OpenBCI/Ganglion_Hardware_Design_Files/README.md

# Ganglion_Hardware_Design_Files
General repo for Ganglion hardware files 

All design files made with KiCad PCB design software.
http://kicad-pcb.org/

Disclaimer:

These files are presented AS IS, with no representation of warranty or functionality.
Designs are subject to change without notice.
