OpenBCI/Ganglion_Hardware_Design_Files/(threads)

Thread 3 (2018-03-22):

Feature Request: Powering the future of neurotech with a 3.3V pin

aj-ptw, 2018-03-22:
Currently the ganglion does not work if you power the Ganglion from the broken out 3.3V

Thread 4 (2018-08-01):

Libraries not found

rehno-lindeque, 2018-08-01:
Hi, upon opening the schematic in kicad I get some missing library links from @biomurph's personal library.

> The following libraries were not found:
>
> /Users/biomurph/Documents/KiCad/library/OpenBCI

biomurph, 2018-08-01:
You need to create a new path for the libraries.
In KiCAD, go to Preferences > Configure Paths
Then point to the OpenBCI_KiCad_librariy_files folder.

Closed 2018-08-01.
