OpenBCI/Ganglion_Hardware_Design_Files/Ganglion_KiCad_Files/Ganglion_01.kicad_pcb

## KiCad design Ganglion_KiCad_Files/Ganglion_01.kicad_pcb (2017-01-11)

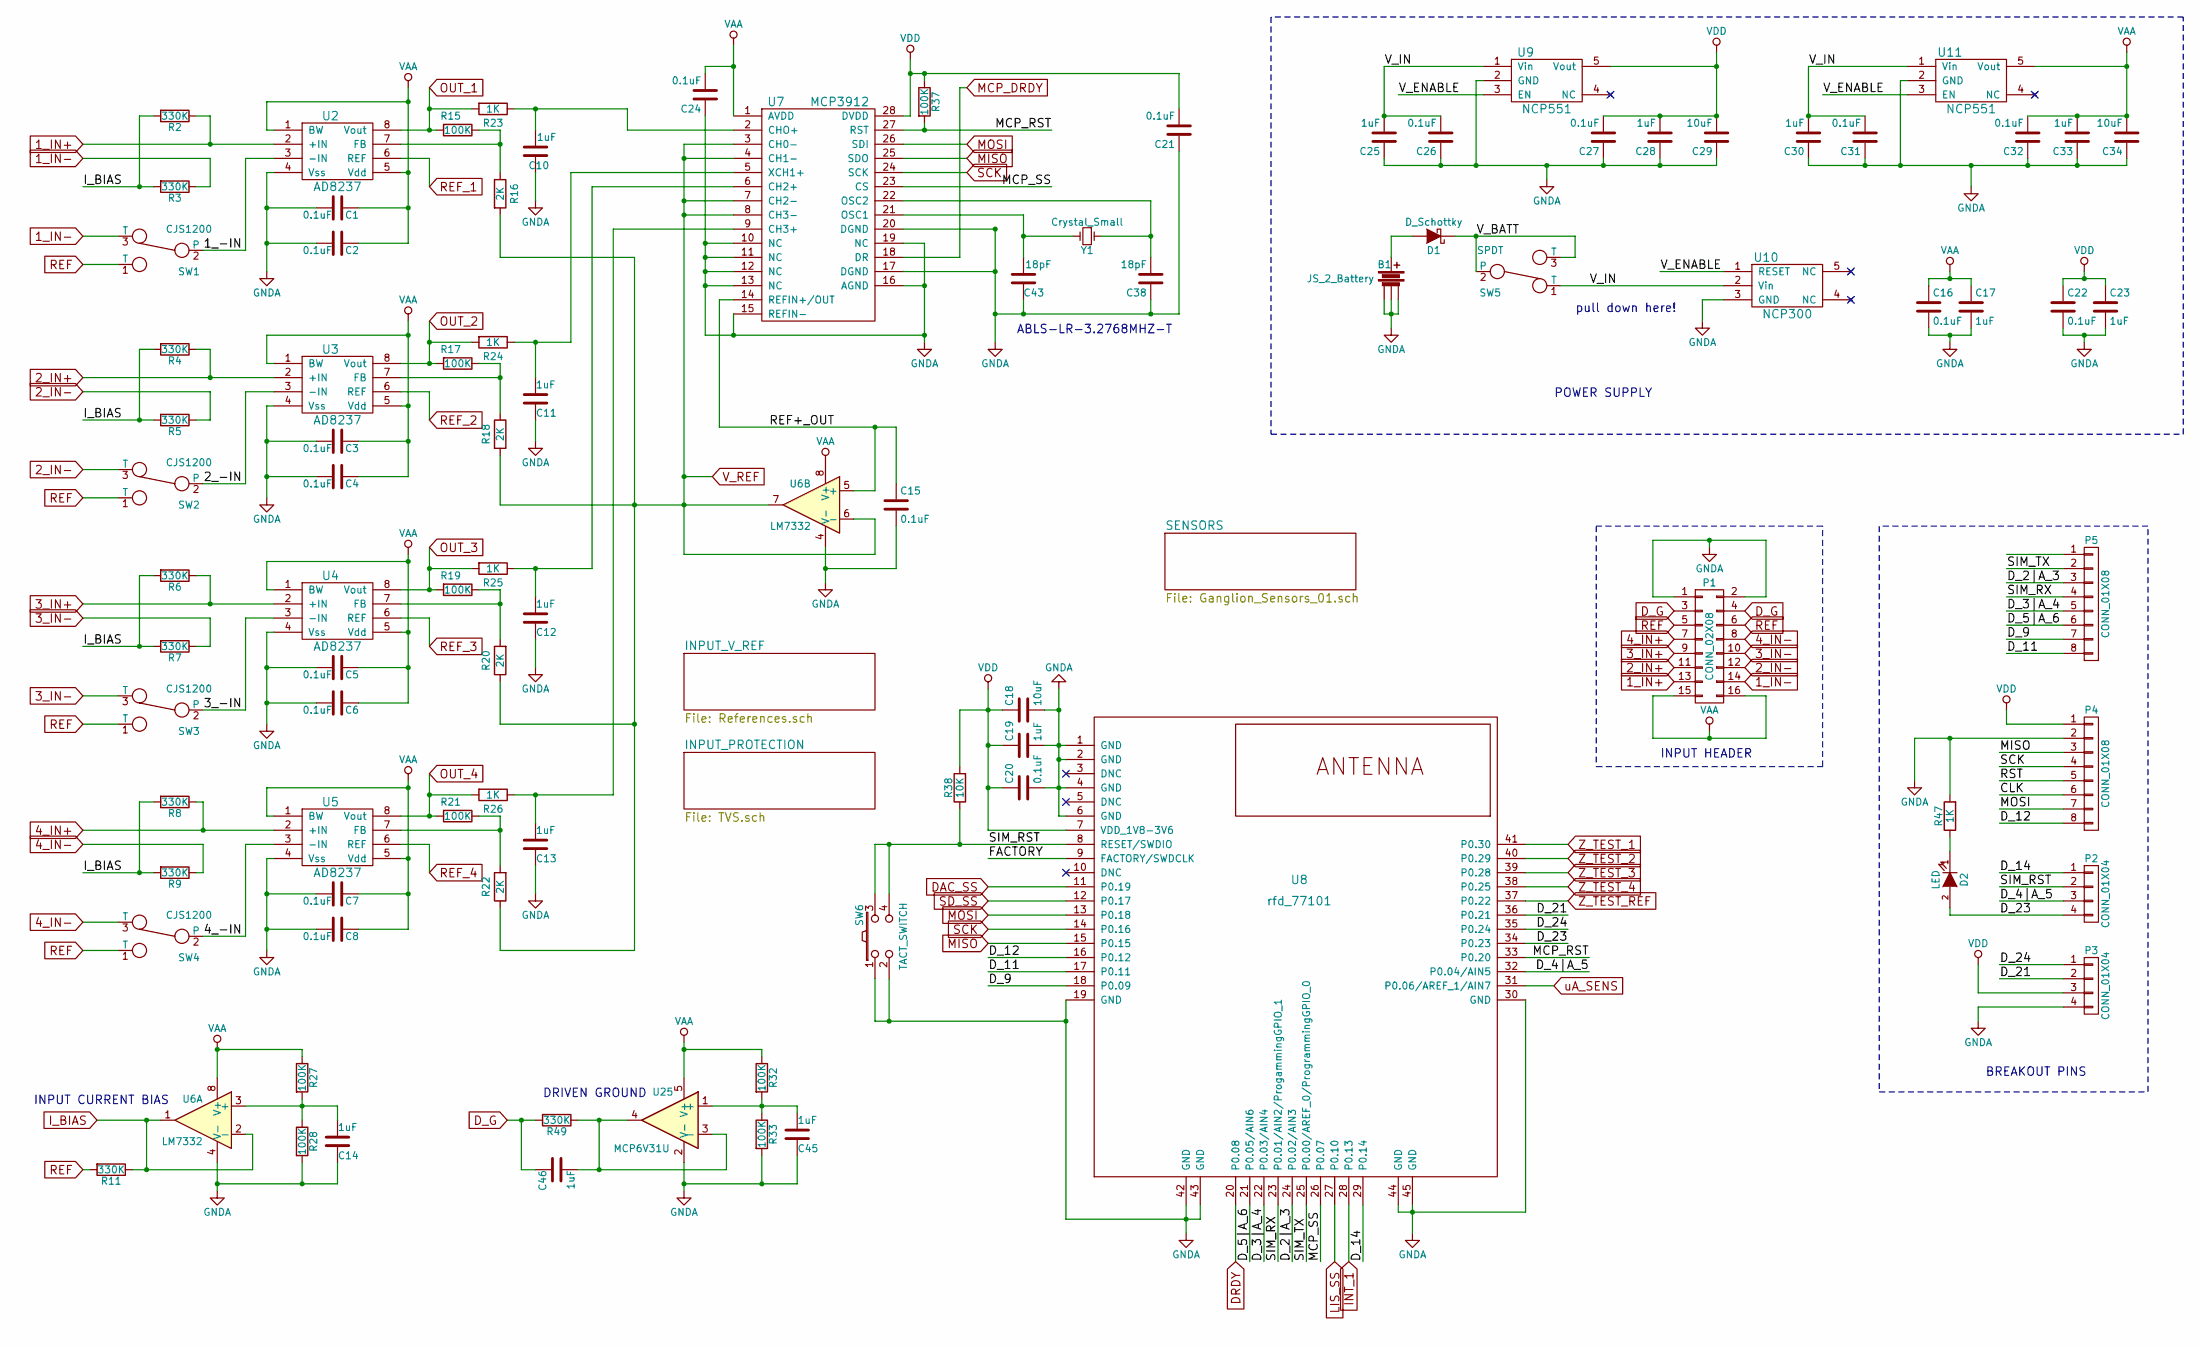
[picture p5: schematic Ganglion_01.sch, Ganglion]

Parts:
B1: JS_2_Battery; JST_RA_SMT
C1, C2, C3, C4, C5, C6, C7, C8, C15, C16, C20, C21, C22, C24, C26, C27, C31, C32: 0.1uF; C_0603
C10, C11, C12, C13, C14, C17, C19, C23, C25, C28, C30, C33, C45, C46: 1uF; C_0603
C18, C29, C34: 10uF; C_0603
C38, C43: 18pF; C_0603
D1: D_Schottky; C_0603
D2: LED; LED_0603
P1: CONN_02X08; Pin_Header_Angled_2x08
P2, P3: CONN_01X04; Socket_Strip_Straight_1x04
P4, P5: CONN_01X08; Socket_Strip_Straight_1x08
R2, R3, R4, R5, R6, R7, R8, R9, R11, R49: 330K; R_0603
R15, R17, R19, R21, R27, R28, R32, R33, R37: 100K; R_0603
R16, R18, R20, R22: 2K; R_0603
R23, R24, R25, R26, R47: 1K; R_0603
R38: 10K; R_0603
SW1, SW2, SW3, SW4: CJS1200; CJS-1200TA
SW5: SPDT; SSSS810701 SSSS810701
SW6: TACT_SWITCH; PTS810
U2, U3, U4, U5: AD8237; MSOP-8_3x3mm_Pitch0.65mm
U6: LM7332; MSOP-8_3x3mm_Pitch0.65mm
U7: MCP3912; SSOP-28_5.3x10.2mm_Pitch0.65mm
U8: rfd_77101; RFD77101
U9, U11: NCP551; SOT-23-5
U10: NCP300; SOT-23-5
U25: MCP6V31U; SC-70-5
Y1: Crystal_Small; Crystal_HC49-SD_SMD

Connections:
1_IN+: P1.13, R2.1, U2.2 (+IN); also elsewhere on the board
1_IN-: P1.14, R3.1, SW1.3 (T); also elsewhere on the board
2_IN+: P1.11, R4.1, U3.2 (+IN); also elsewhere on the board
2_IN-: P1.12, R5.1, SW2.3 (T); also elsewhere on the board
3_IN+: P1.9, R6.1, U4.2 (+IN); also elsewhere on the board
3_IN-: P1.10, R7.1, SW3.3 (T); also elsewhere on the board
4_IN+: P1.7, R8.1, U5.2 (+IN); also elsewhere on the board
4_IN-: P1.8, R9.1, SW4.3 (T); also elsewhere on the board
/1_-IN: SW1.2, U2.3 (-IN)
/2_-IN: SW2.2, U3.3 (-IN)
/3_-IN: SW3.2, U4.3 (-IN)
/4_-IN: SW4.2, U5.3 (-IN)
/CLK: P4.6
/D_2|A_3: P5.3, U8.24 (P0.02/AIN3)
/D_3|A_4: P5.5, U8.22 (P0.03/AIN4)
/D_4|A_5: P2.3, U8.32 (P0.04/AIN5)
/D_5|A_6: P5.6, U8.21 (P0.05/AIN6)
/D_9: P5.7, U8.18 (P0.09)
/D_11: P5.8, U8.17 (P0.11)
/D_12: P4.8, U8.16 (P0.12)
/D_14: P2.1, U8.29 (P0.14)
/D_21: P3.2, U8.36 (P0.21)
/D_23: D2.2 (A), P2.4, U8.34 (P0.23)
/D_24: P3.1, U8.35 (P0.24)
/FACTORY: U8.9 (FACTORY/SWDCLK)
/MCP_RST: R37.2, U7.27 (RST), U8.33 (P0.20)
/MCP_SS: U7.23 (CS), U8.26 (P0.07)
/REF+_OUT: C15.1, U6.5 (+), U7.14 (REFIN+/OUT)
/RST: P4.5
/SIM_RST: P2.2, R38.1, SW6.3, SW6.4, U8.8 (RESET/SWDIO)
/SIM_RX: P5.4, U8.23 (P0.01/AIN2/ProgammingGPIO_1)
/SIM_TX: P5.2, U8.25 (P0.00/AREF_0/ProgrammingGPIO_0)
/V_BATT: D1.1 (K), SW5.2, SW5.3 (T)
/V_ENABLE: U9.3 (EN), U10.1 (RESET), U11.3 (EN)
/V_IN: C25.2, C26.2, C30.2, C31.2, SW5.1 (T), U9.1 (Vin), U10.2 (Vin), U11.1 (Vin)
DAC_SS: U8.11 (P0.19); also elsewhere on the board
DRDY: U8.20 (P0.08); also elsewhere on the board
D_G: C46.2, P1.3, P1.4, R49.2; also elsewhere on the board
GNDA: B1.2, B1.3, B1.4, C1.2, C2.2, C3.2, C4.2, C5.2, C6.2, C7.2, C8.2, C10.1, C11.2, C12.2, C13.2, C14.2, C15.2, C16.2, C17.2, C18.2, C19.2, C20.2, C21.1, C22.2, C23.2, C24.1, C25.1, C26.1, C27.1, C28.1, C29.1, C30.1, C31.1, C32.1, C33.1, C34.1, C38.1, C43.1, C45.2, P1.1, P1.2, P3.4, P4.2, R28.2, R33.2, R47.2, SW6.1, SW6.2, U2.4 (Vss), U3.4 (Vss), U4.4 (Vss), U5.4 (Vss), U6.4 (V-), U7.10 (NC), U7.11 (NC), U7.12 (NC), U7.13 (NC), U7.15 (REFIN-), U7.16 (AGND), U7.17 (DGND), U7.19 (NC), U7.20 (DGND), U8.1 (GND), U8.2 (GND), U8.4 (GND), U8.6 (GND), U8.19 (GND), U8.30 (GND), U8.42 (GND), U8.43 (GND), U8.44 (GND), U8.45 (GND), U9.2 (GND), U10.3 (GND), U11.2 (GND), U25.2 (V-); also elsewhere on the board
INT_1: U8.28 (P0.13); also elsewhere on the board
I_BIAS: R2.2, R3.2, R4.2, R5.2, R6.2, R7.2, R8.2, R9.2, R11.1, U6.1, U6.2 (-)
LIS_SS: U8.27 (P0.10); also elsewhere on the board
MCP_DRDY: U7.18 (DR); also elsewhere on the board
MISO: P4.3, U7.25 (SDO), U8.15 (P0.15); also elsewhere on the board
MOSI: P4.7, U7.26 (SDI), U8.13 (P0.18); also elsewhere on the board
unnamed: B1.1, D1.2 (A)
unnamed: C10.2, R23.1, U7.2 (CHO+)
unnamed: C11.1, R24.1, U7.5 (XCH1+)
unnamed: C12.1, R25.1, U7.6 (CH2+)
unnamed: C13.1, R26.1, U7.9 (CH3+)
unnamed: C14.1, R27.2, R28.1, U6.3 (+)
unnamed: C38.2, U7.22 (OSC2), Y1.1
unnamed: C43.2, U7.21 (OSC1), Y1.2
unnamed: C45.1, R32.2, R33.1, U25.1 (+)
unnamed: C46.1, R49.1, U25.3 (-), U25.4
unnamed: D2.1 (K), R47.1
unnamed: R15.1, R16.1, U2.7 (FB)
unnamed: R17.1, R18.1, U3.7 (FB)
unnamed: R19.1, R20.2, U4.7 (FB)
unnamed: R21.1, R22.2, U5.7 (FB)
OUT_1: R15.2, R23.2, U2.8 (Vout); also elsewhere on the board
OUT_2: R17.2, R24.2, U3.8 (Vout); also elsewhere on the board
OUT_3: R19.2, R25.2, U4.8 (Vout); also elsewhere on the board
OUT_4: R21.2, R26.2, U5.8 (Vout); also elsewhere on the board
REF: P1.5, P1.6, R11.2, SW1.1 (T), SW2.1 (T), SW3.1 (T), SW4.1 (T); also elsewhere on the board
REF_1: U2.6 (REF); also elsewhere on the board
REF_2: U3.6 (REF); also elsewhere on the board
REF_3: U4.6 (REF); also elsewhere on the board
REF_4: U5.6 (REF); also elsewhere on the board
SCK: P4.4, U7.24 (SCK), U8.14 (P0.16); also elsewhere on the board
SD_SS: U8.12 (P0.17); also elsewhere on the board
VAA: C1.1, C2.1, C3.1, C4.1, C5.1, C6.1, C7.1, C8.1, C16.1, C17.1, C24.2, C32.2, C33.2, C34.2, P1.15, P1.16, R27.1, R32.1, U2.1 (BW), U2.5 (Vdd), U3.1 (BW), U3.5 (Vdd), U4.1 (BW), U4.5 (Vdd), U5.1 (BW), U5.5 (Vdd), U6.8 (V+), U7.1 (AVDD), U11.5 (Vout), U25.5 (V+); also elsewhere on the board
VDD: C18.1, C19.1, C20.1, C21.2, C22.1, C23.1, C27.2, C28.2, C29.2, P3.3, P4.1, R37.1, R38.2, U7.28 (DVDD), U8.7 (VDD_1V8-3V6), U9.5 (Vout); also elsewhere on the board
V_REF: R16.2, R18.2, R20.1, R22.1, U6.6 (-), U6.7, U7.3 (CH0-), U7.4 (CH1-), U7.7 (CH2-), U7.8 (CH3-); also elsewhere on the board
Z_TEST_1: U8.41 (P0.30); also elsewhere on the board
Z_TEST_2: U8.40 (P0.29); also elsewhere on the board
Z_TEST_3: U8.39 (P0.28); also elsewhere on the board
Z_TEST_4: U8.38 (P0.25); also elsewhere on the board
Z_TEST_REF: U8.37 (P0.22); also elsewhere on the board
uA_SENS: U8.31 (P0.06/AREF_1/AIN7); also elsewhere on the board

Notes on the sheet:
POWER SUPPLY
BREAKOUT PINS
pull down here!
ABLS-LR-3.2768MHZ-T
DRIVEN GROUND
INPUT CURRENT BIAS
INPUT HEADER

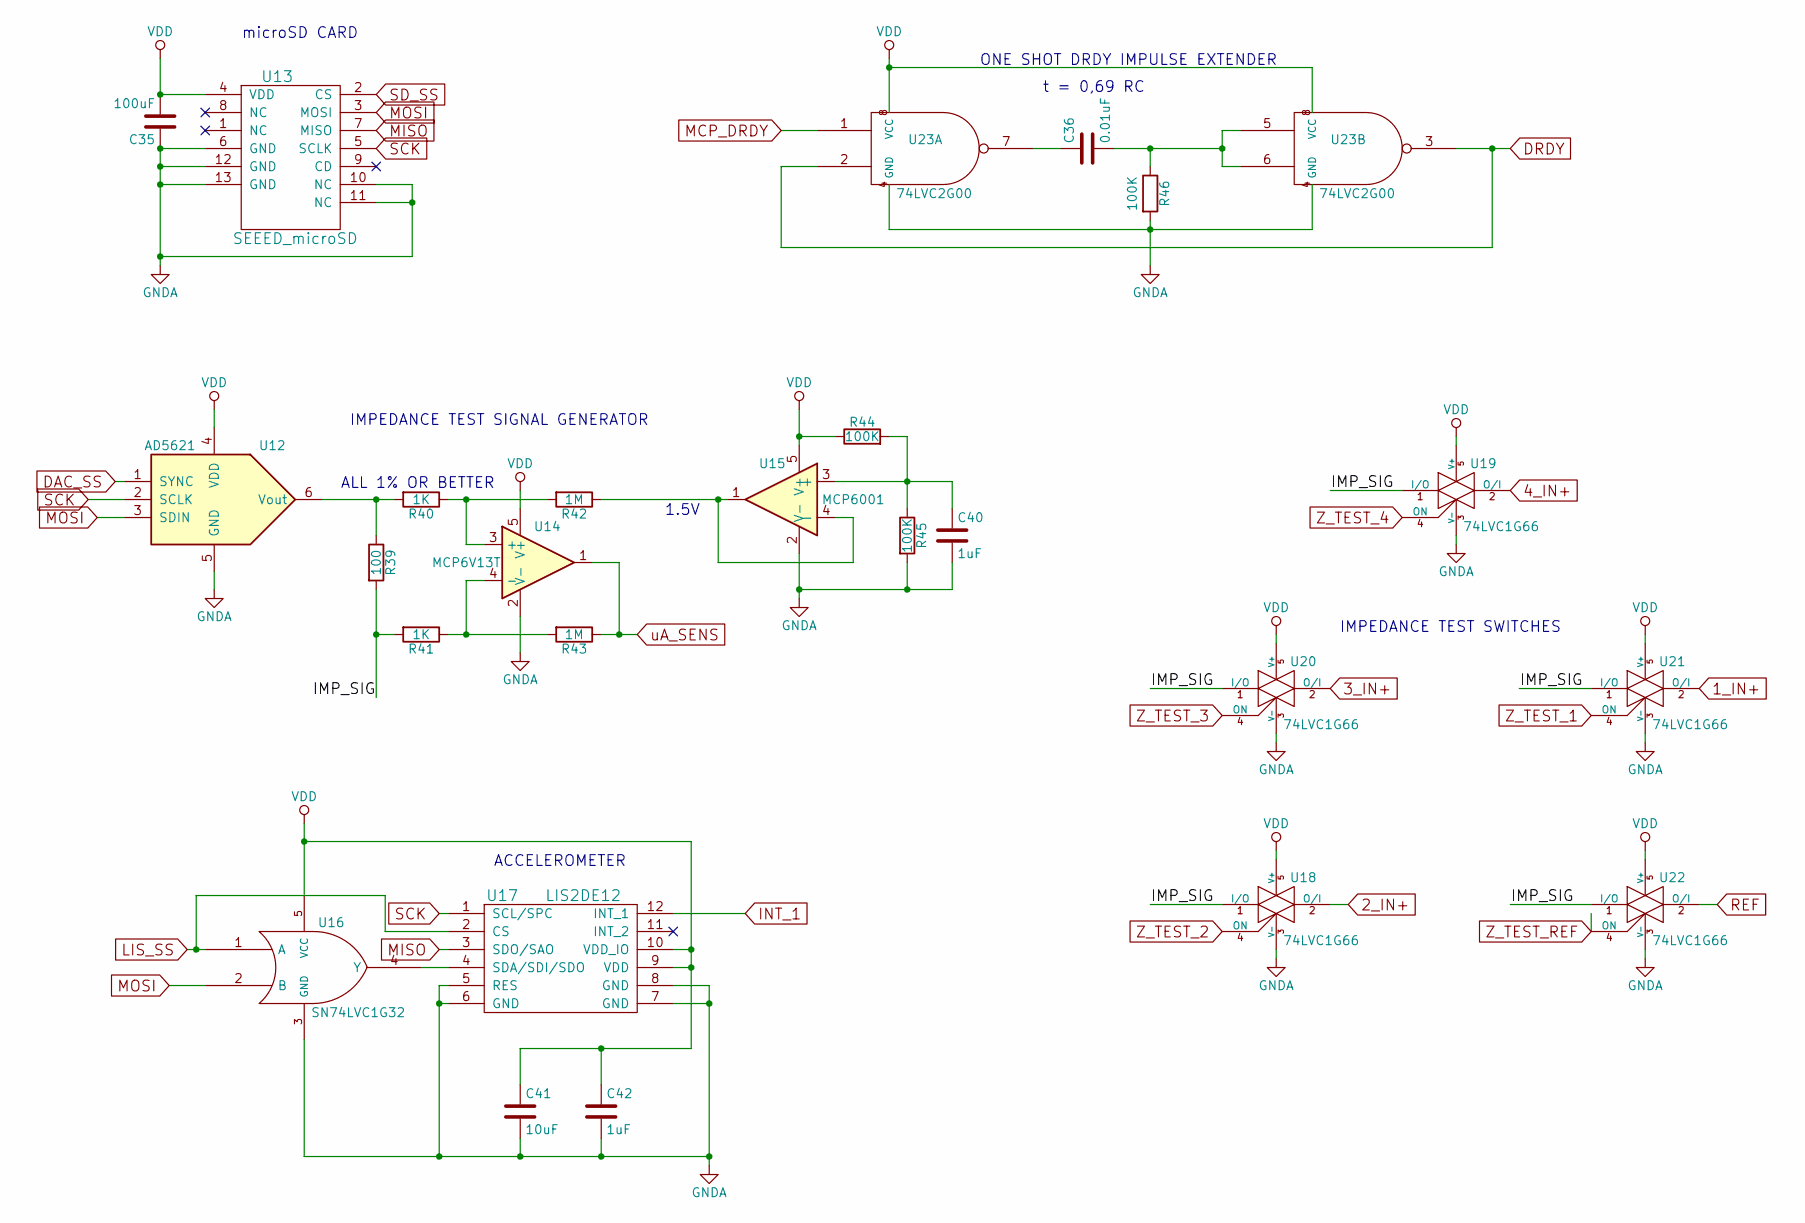
[picture p6: schematic Ganglion_Sensors_01.sch, Ganglion Peripherals]

Parts:
C35: 100uF; C_1210
C36: 0.01uF; C_0603
C40, C42: 1uF; C_0603
C41: 10uF; C_0603
R39: 100; R_0603
R40, R41: 1K; R_0603
R42, R43: 1M; R_0603
R44, R45, R46: 100K; R_0603
U12: AD5621; SC-70-6
U13: SEEED_microSD; ST-TF-0003A
U14: MCP6V13T; SOT-23-5
U15: MCP6001; SC-70-5
U16: SN74LVC1G32; SC-70-5
U17: LIS2DE12; LIS2DH12
U18, U19, U20, U21, U22: 74LVC1G66; SC-70-5
U23: 74LVC2G00; VSSOP-8

Connections:
1_IN+: U21.2 (O/I); also elsewhere on the board
2_IN+: U18.2 (O/I); also elsewhere on the board
3_IN+: U20.2 (O/I); also elsewhere on the board
4_IN+: U19.2 (O/I); also elsewhere on the board
/SENSORS/IMP_SIG: R39.2, R41.2, U18.1 (I/O), U19.1 (I/O), U20.1 (I/O), U21.1 (I/O), U22.1 (I/O)
DAC_SS: U12.1 (SYNC); also elsewhere on the board
DRDY: U23.2, U23.3; also elsewhere on the board
GNDA: C35.1, C40.2, C41.2, C42.2, R45.2, R46.2, U12.5 (GND), U13.6 (GND), U13.10 (NC), U13.11 (NC), U13.12 (GND), U13.13 (GND), U14.2 (V-), U15.2 (V-), U16.3 (GND), U17.5 (RES), U17.6 (GND), U17.7 (GND), U17.8 (GND), U18.3 (V-), U19.3 (V-), U20.3 (V-), U21.3 (V-), U22.3 (V-), U23.4 (GND); also elsewhere on the board
INT_1: U17.12 (INT_1); also elsewhere on the board
LIS_SS: U16.1 (A), U17.2 (CS); also elsewhere on the board
MCP_DRDY: U23.1; also elsewhere on the board
MISO: U13.7 (MISO), U17.3 (SDO/SAO); also elsewhere on the board
MOSI: U12.3 (SDIN), U13.3 (MOSI), U16.2 (B); also elsewhere on the board
unnamed: C36.1, U23.7
unnamed: C36.2, R46.1, U23.5, U23.6
unnamed: C40.1, R44.2, R45.1, U15.3 (+)
unnamed: R39.1, R40.2, U12.6 (Vout)
unnamed: R40.1, R42.2, U14.3 (+)
unnamed: R41.1, R43.2, U14.4 (-)
unnamed: R42.1, U15.1, U15.4 (-)
unnamed: U16.4 (Y), U17.4 (SDA/SDI/SDO)
REF: U22.2 (O/I); also elsewhere on the board
SCK: U12.2 (SCLK), U13.5 (SCLK), U17.1 (SCL/SPC); also elsewhere on the board
SD_SS: U13.2 (CS); also elsewhere on the board
VDD: C35.2, C41.1, C42.1, R44.1, U12.4 (VDD), U13.4 (VDD), U14.5 (V+), U15.5 (V+), U16.5 (VCC), U17.9 (VDD), U17.10 (VDD_IO), U18.5 (V+), U19.5 (V+), U20.5 (V+), U21.5 (V+), U22.5 (V+), U23.8 (VCC); also elsewhere on the board
Z_TEST_1: U21.4 (ON); also elsewhere on the board
Z_TEST_2: U18.4 (ON); also elsewhere on the board
Z_TEST_3: U20.4 (ON); also elsewhere on the board
Z_TEST_4: U19.4 (ON); also elsewhere on the board
Z_TEST_REF: U22.4 (ON); also elsewhere on the board
uA_SENS: R43.1, U14.1; also elsewhere on the board

Notes on the sheet:
1.5V
ALL 1% OR BETTER
ACCELEROMETER
microSD CARD
IMPEDANCE TEST SIGNAL GENERATOR
ONE SHOT DRDY IMPULSE EXTENDER
t = 0,69 RC
IMPEDANCE TEST SWITCHES

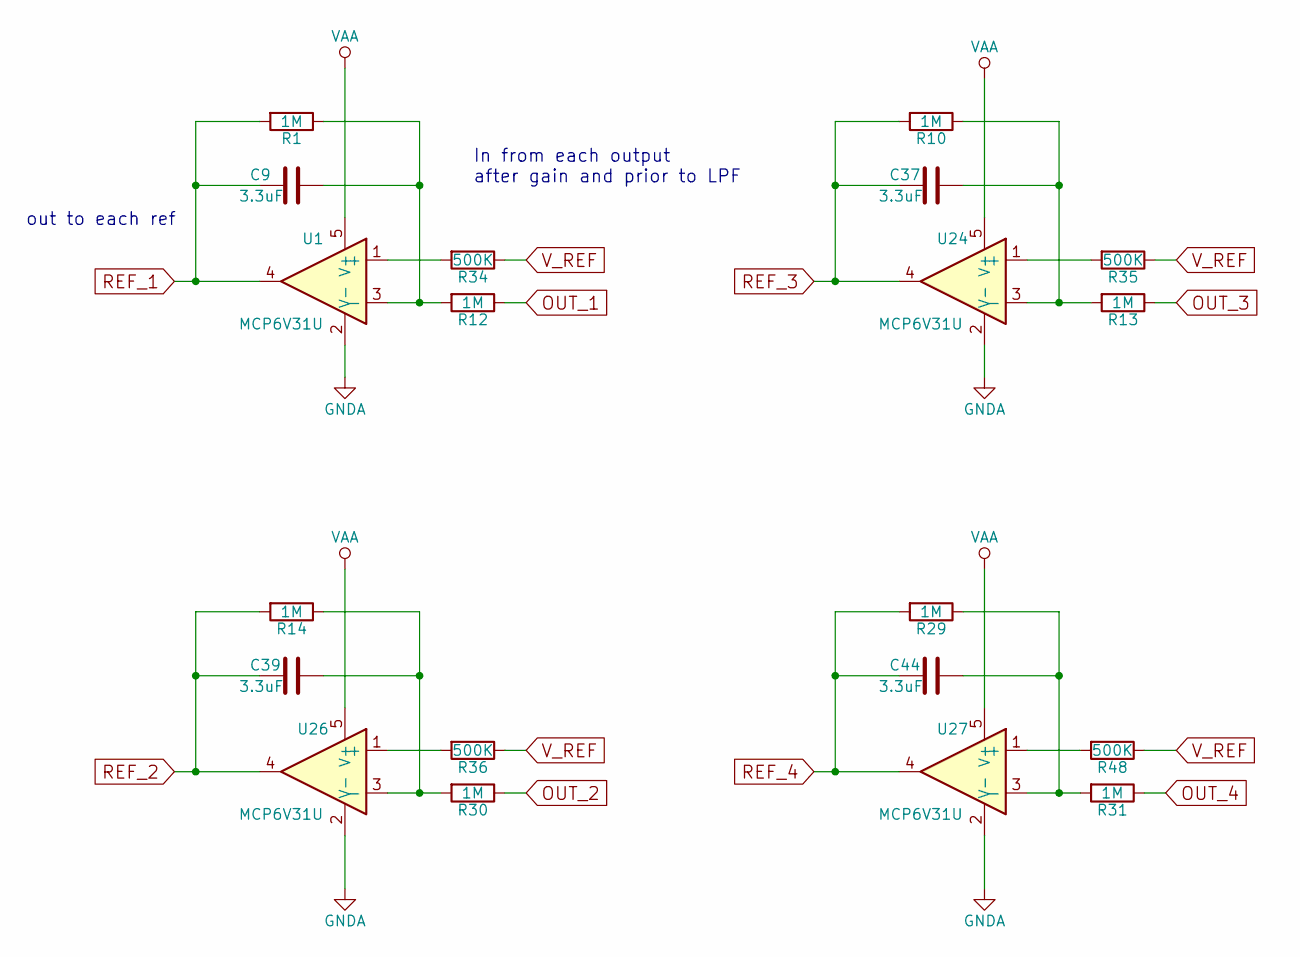
[picture p7: schematic References.sch, Ganglion Input Voltage References]

Parts:
C9, C37, C39, C44: 3.3uF; C_0603
R1, R10, R12, R13, R14, R29, R30, R31: 1M; C_0603
R34, R35, R36, R48: 500K; C_0603
U1, U24, U26, U27: MCP6V31U; SC-70-5

Connections:
GNDA: U1.2 (V-), U24.2 (V-), U26.2 (V-), U27.2 (V-); also elsewhere on the board
unnamed: C9.1, R1.1, R12.2, U1.3 (-)
unnamed: C37.1, R10.1, R13.2, U24.3 (-)
unnamed: C39.1, R14.1, R30.2, U26.3 (-)
unnamed: C44.1, R29.1, R31.2, U27.3 (-)
unnamed: R34.2, U1.1 (+)
unnamed: R35.2, U24.1 (+)
unnamed: R36.2, U26.1 (+)
unnamed: R48.2, U27.1 (+)
OUT_1: R12.1; also elsewhere on the board
OUT_2: R30.1; also elsewhere on the board
OUT_3: R13.1; also elsewhere on the board
OUT_4: R31.1; also elsewhere on the board
REF_1: C9.2, R1.2, U1.4; also elsewhere on the board
REF_2: C39.2, R14.2, U26.4; also elsewhere on the board
REF_3: C37.2, R10.2, U24.4; also elsewhere on the board
REF_4: C44.2, R29.2, U27.4; also elsewhere on the board
VAA: U1.5 (V+), U24.5 (V+), U26.5 (V+), U27.5 (V+); also elsewhere on the board
V_REF: R34.1, R35.1, R36.1, R48.1; also elsewhere on the board

Notes on the sheet:
In from each output after gain and prior to LPF
out to each ref

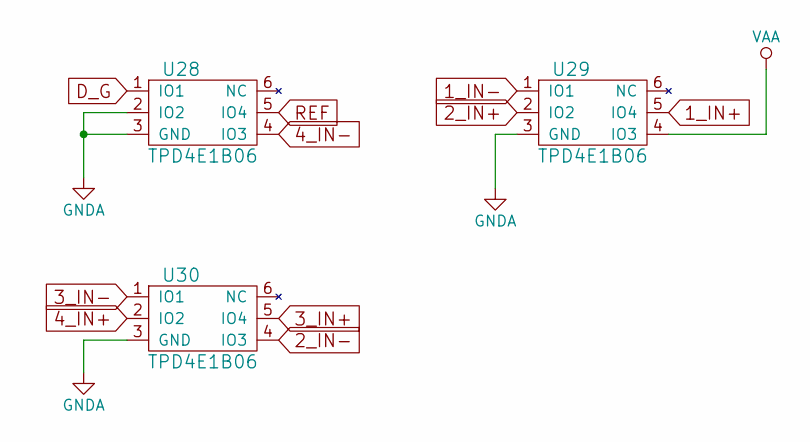
[picture p8: schematic TVS.sch, Ganglion Input Protection]

Parts:
U28, U29, U30: TPD4E1B06; SC-70-6

Connections:
1_IN+: U29.5 (IO4); also elsewhere on the board
1_IN-: U29.1 (IO1); also elsewhere on the board
2_IN+: U29.2 (IO2); also elsewhere on the board
2_IN-: U30.4 (IO3); also elsewhere on the board
3_IN+: U30.5 (IO4); also elsewhere on the board
3_IN-: U30.1 (IO1); also elsewhere on the board
4_IN+: U30.2 (IO2); also elsewhere on the board
4_IN-: U28.4 (IO3); also elsewhere on the board
D_G: U28.1 (IO1); also elsewhere on the board
GNDA: U28.2 (IO2), U28.3 (GND), U29.3 (GND), U30.3 (GND); also elsewhere on the board
REF: U28.5 (IO4); also elsewhere on the board
VAA: U29.4 (IO3); also elsewhere on the board

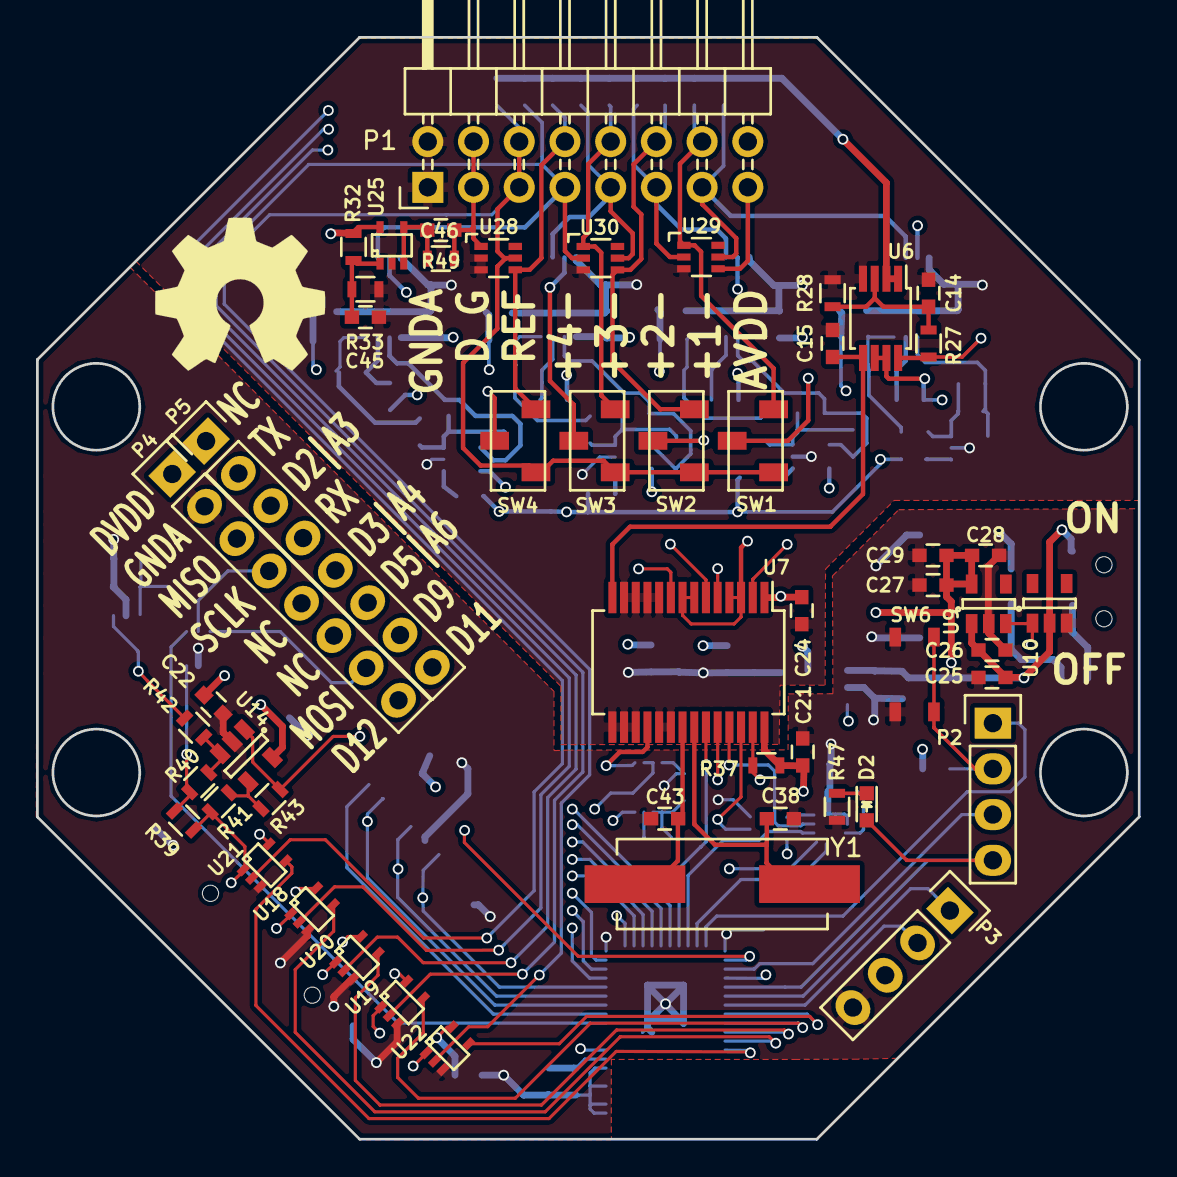
[picture p9: board Ganglion_01.kicad_pcb from above]

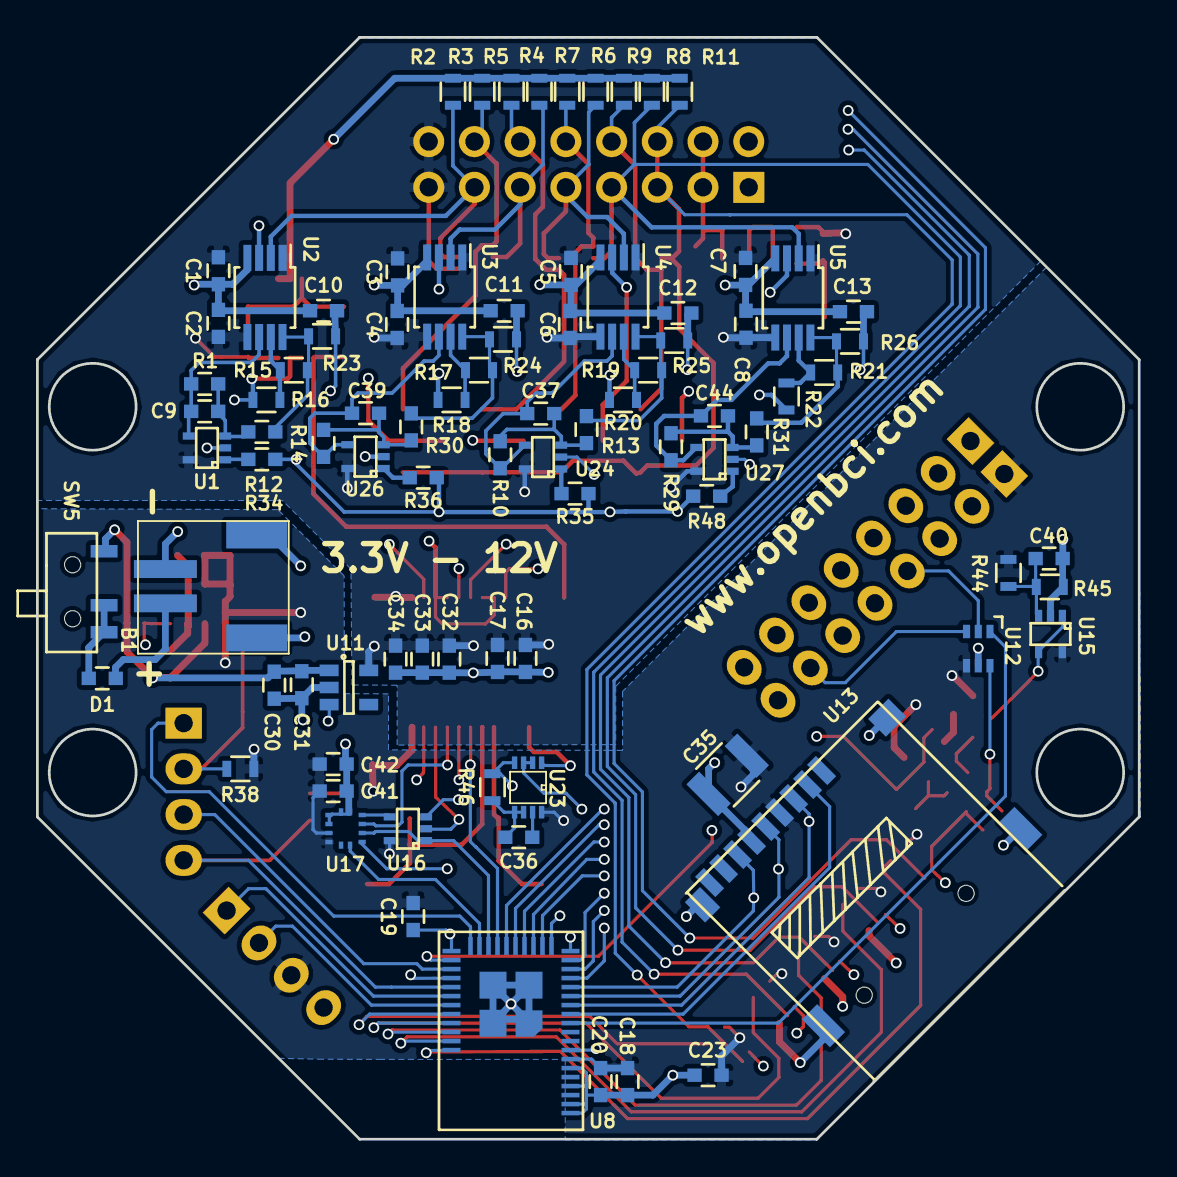
[picture p10: board Ganglion_01.kicad_pcb from below]

Board: 4 copper layers, 61.2 x 61.2 mm, 140 parts (88 on the bottom side), 94 nets.
