OpenBCI/Ganglion_Hardware_Design_Files/(commit log)

2016-10-18 Initial Commit
    Dropping KiCad Schematic and library files
    [Ganglion_01.sch, Ganglion_Sensors_01.sch, References.sch]
2016-10-18 added PDF of Schematic
    [Ganglion_01.sch, References.sch]
2016-10-19 small changes
    improved readability of shcematic
    [Ganglion_01.sch]
2016-10-24 small changes
    [Ganglion_01.sch, Ganglion_Sensors_01.sch, References.sch]
2017-01-11 Commit PCB files
    Update with the production schematic and PCB files. Also the BOM.
    You’re welcome.
    [Ganglion_01.kicad_pcb, Ganglion_01.sch, Ganglion_01_BOM.xlsx, Ganglion_Sensors_01.sch, References.sch, TVS.sch]
2017-09-18 Update License and add berbers
    [Ganglion_01-B.Cu.gbr, Ganglion_01-B.Mask.gbr, Ganglion_01-B.Paste.gbr, Ganglion_01-Edge.Cuts.gbr, Ganglion_01-F.Cu.gbr, Ganglion_01-F.Mask.gbr, Ganglion_01-F.Paste.gbr, Ganglion_01-In1.Cu.gbr]
2018-01-08 Updated Schematic to v1.0.1
    made chante to Vref Capacitors. Was 3.3uF, now 22uF
    [Ganglion_01_BOM.xlsx]
2023-12-18 Delete Ganglion_KiCad_Files/OpenBCI_KiCad_library_files/OpenBCI.pretty directory
    Remove KiCad pretty directory
2023-12-18 added pick and place files
    [Ganglion_01-bottom-pos.csv, Ganglion_01-top-pos.csv]
